SkyGuide-Azhar/SkyGuide/README.md

# SkyGuide

This project is aiming to make and control a sky pointer device which will enable the user to point and track any object in the sky.
The device can be used as a Telescope German Equatorial Go-To Mount.

The project consists of two parts:
  - Desktop app to enable the user to send the required celestial object position to the mount.
  - Physical device that recieves the required celestial object position from the desktop app and moves twoards this position.

-----------------------------------------------------------------------------------------------------------------------------------------

Participants:
  - Sherif Gamal Abdellatif
  - Abdelrahman Farouk Sayed
  - Attia Ali Attia
  - Ahmed Sedek Ali
  - Ahmed Ragab Abdelkader
