SkyGuide-Azhar/SkyGuide/Doc and Presentation/ProgramsUsed.docx

Programs Used

Python 3.9, QtCreator, Arduino IDE, TinkerCad
