SkyGuide-Azhar/SkyGuide/Hardware Device/3d Design/gyro_mount.stl

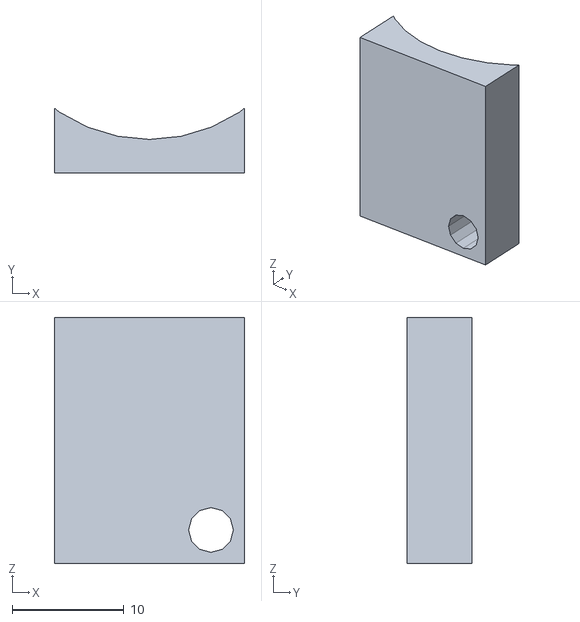
[picture p1: CAD file, 2021-09-16]
Hardware Device/3d Design/gyro_mount.stl
17.0 x 5.81 x 22.0
