SkyGuide-Azhar/SkyGuide/Hardware Device/3d Design/small_gear_DEC.stl

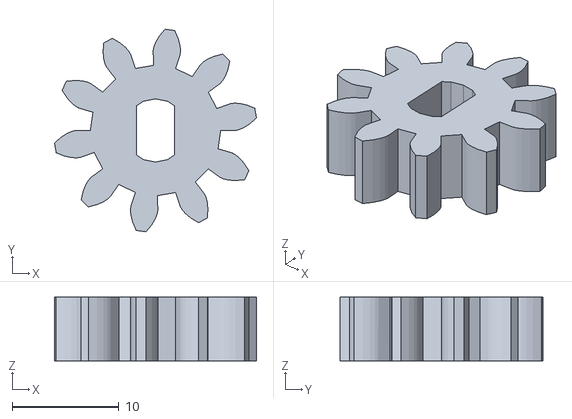
[picture p3: CAD file, 2021-09-16]
Hardware Device/3d Design/small_gear_DEC.stl
19.0 x 19.0 x 6.00
