SkyGuide-Azhar/SkyGuide/Hardware Device/3d Design/DEC_mount.stl

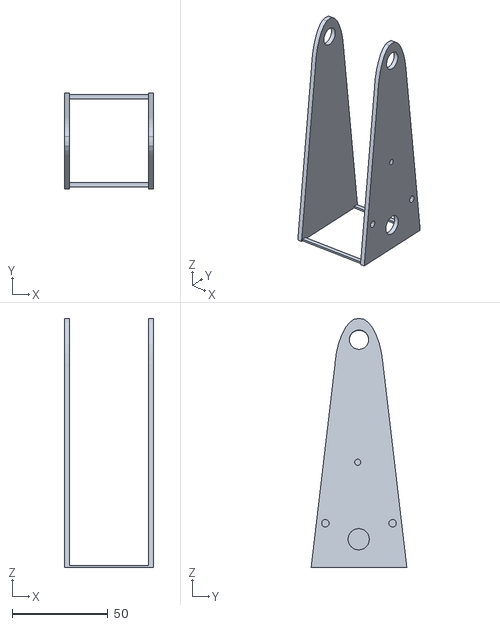
[picture p4: CAD file, 2021-09-16]
Hardware Device/3d Design/DEC_mount.stl
46.4 x 50.0 x 130.0
