SkyGuide-Azhar/SkyGuide/Hardware Device/3d Design/base_gear_small.stl

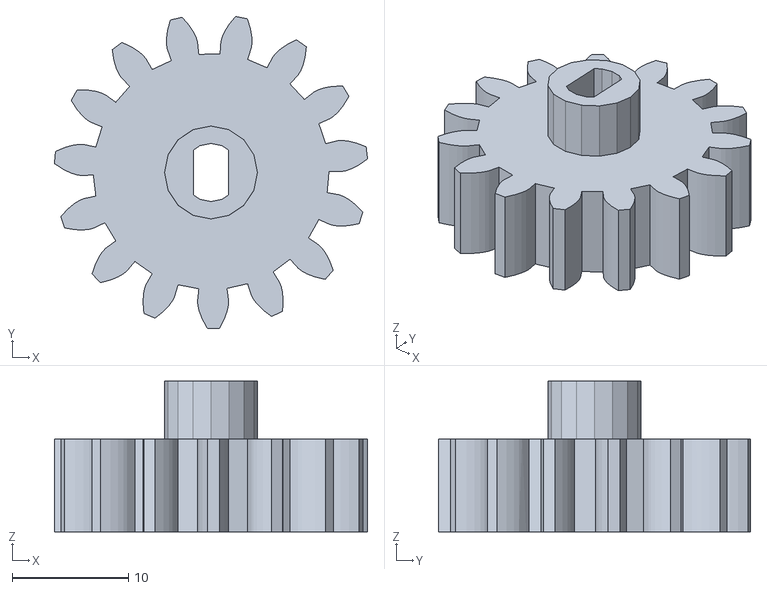
[picture p5: CAD file, 2021-09-16]
Hardware Device/3d Design/base_gear_small.stl
27.0 x 26.9 x 13.0
