SkyGuide-Azhar/SkyGuide/Hardware Device/3d Design/second_gear_DEC.stl

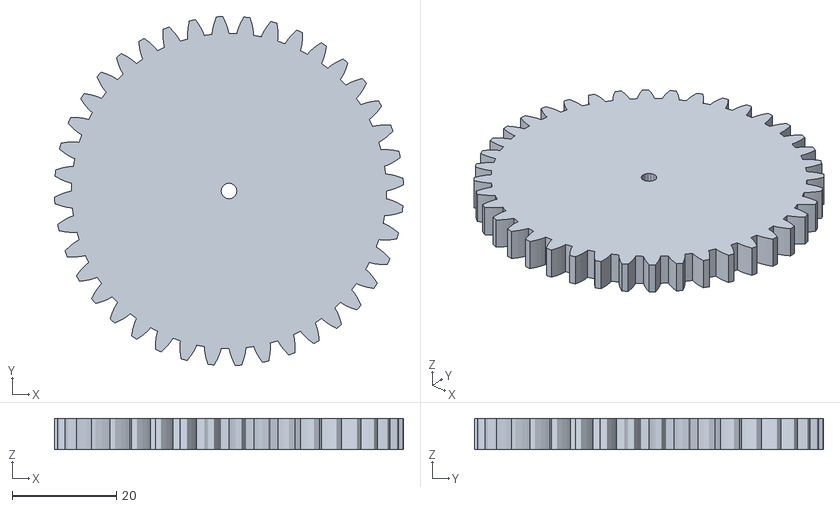
[picture p6: CAD file, 2021-09-16]
Hardware Device/3d Design/second_gear_DEC.stl
66.8 x 66.8 x 6.00
