SkyGuide-Azhar/SkyGuide/Hardware Device/3d Design/tripod_mount.stl

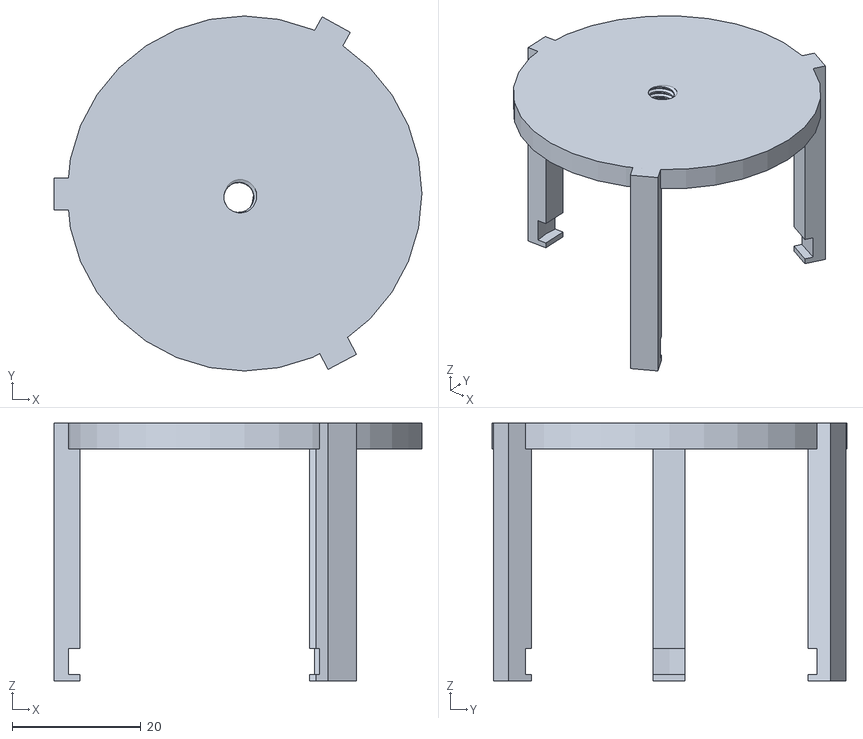
[picture p7: CAD file, 2021-09-16]
Hardware Device/3d Design/tripod_mount.stl
57.1 x 55.1 x 40.0
