SkyGuide-Azhar/SkyGuide/Hardware Device/3d Design/laser_mount.stl

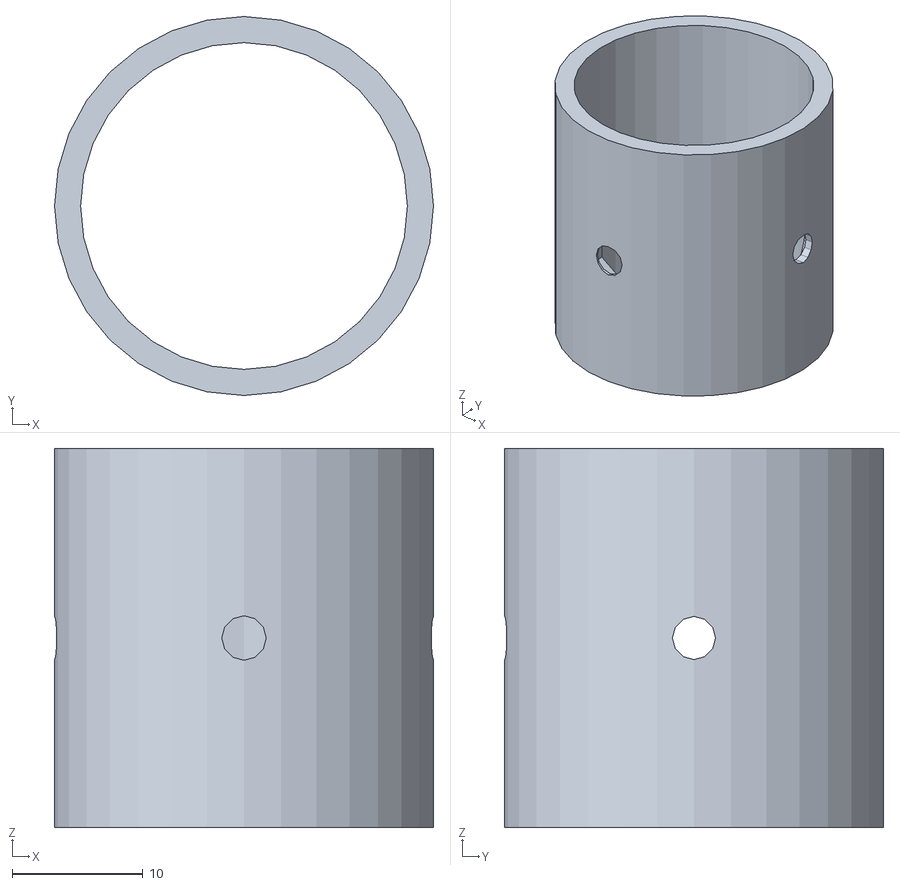
[picture p8: CAD file, 2021-09-16]
Hardware Device/3d Design/laser_mount.stl
29.0 x 29.0 x 29.0
