SkyGuide-Azhar/SkyGuide/Hardware Device/3d Design/base.stl

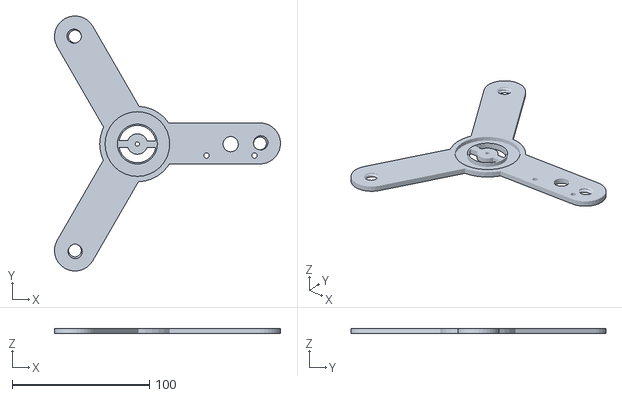
[picture p9: CAD file, 2021-09-16]
Hardware Device/3d Design/base.stl
165.0 x 186.1 x 4.00
