SkyGuide-Azhar/SkyGuide/Hardware Device/3d Design/base_gear_big.stl

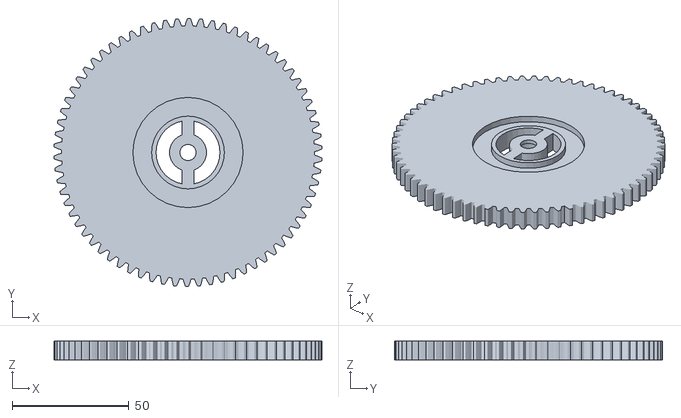
[picture p10: CAD file, 2021-09-16]
Hardware Device/3d Design/base_gear_big.stl
114.6 x 114.6 x 8.00
