SkyGuide-Azhar/SkyGuide/Hardware Device/3d Design/base_screw x 3.stl

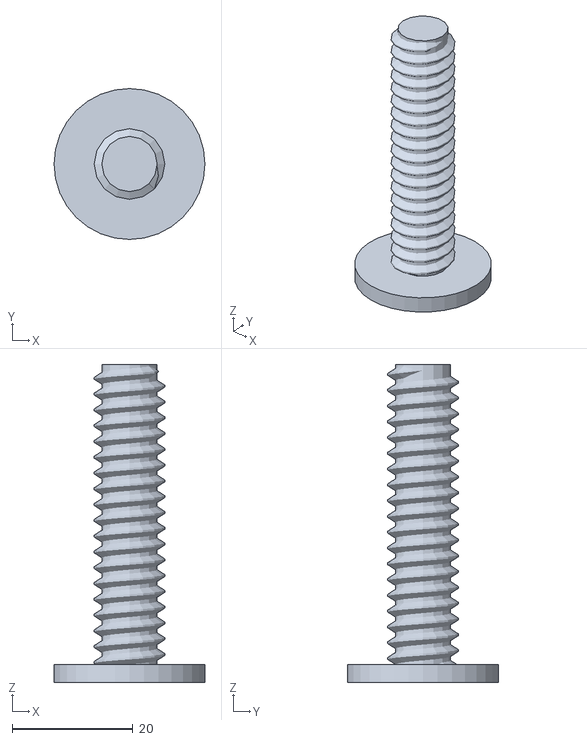
[picture p11: CAD file, 2021-09-16]
Hardware Device/3d Design/base_screw x 3.stl
25.0 x 25.0 x 52.7
