SkyGuide-Azhar/SkyGuide/Doc and Presentation/SkyGuide_Documentation.pdf

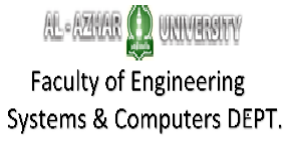
[picture p12: figure]
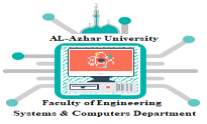
[picture p13: figure]

## Graduation Project Documentation

## Sky Guide / Tracker

## A Project Submitted in partial fulfilment of the requirements for the Degree of Bachelor of Science in Systems and Computers Engineering

## Submitted By

## Sherif Gamal Abdellatif 404045 Abdelrahman Farouk Sayed 404052

Attia Sayed Attia | 404060
Ahmed Sedek Ali | 404010
Ahmed Ragab Abdelkader | 4040111

## Supervised by Dr. Khalid Elshafey

2020/2021

Sky Guide / Tracker 2020/2021

### Each graduation project is assigned to an examiner committee. The committee has three members nominated by the graduation project committee. The examiner committee has a president, and two more members such that the project supervisor is one of the two members. The

name, rule, and signature of each examiner is shown in the following table.

### The examiners' signatures are required before students can submit their project final report/documentation. Therefore, students are responsible for

asking each examiner to sign next to his name in the following table.

Examiner Committee

Name | Rule | Signature
Prof. | President
Dr. | Supervisor
Dr. | Member

ABSTRACT

For most people, the night sky is a mystery because it’s really difficult to find a

certain object in the night sky using the naked eye, however, in reality the night sky is a

detailed map;

Just like the coordinates of any place on earth, each celestial object can be located using

specific coordinates, our project aims to exploit this fact.

Sky Guide consists of two main parts that enable the user to find and track any object in

the sky, these are:

- Desktop application:

We’ve established a moderate database, that contains a set of coordinates and

information for some of the most famous celestial objects (stars, nebulas, etc);

From the desktop application we access this database to retrieve the coordinates

of the required object, and send it to the physical device.

- Physical device:

The device receives the coordinates of the required object -from the desktop

application- and points toward it.

This project is targeting the amateur astronomers and the astrophotography community,

and it can be used as a Telescope German Equatorial Go-To Mount.

KEYWORDS: Astronomy; Astrophotography; Telescope Mount;

ACKNOWLEDGEMENTS

"Praise be to Allah, who guided us to this and we would never have been guided if

Allah had not guided us."

We would like to thank Dr. Khaled Al-Shafei for advice, encourage, support and

mentoring has offered us during project also in the class.

We would like to thank our friend and colleague Eng. Mostafa Arafa from the department

of mechanics, for helping us greatly in the design of the physical device.

Also, we would like to thank staff doctors and Engineers of facility members of the

department of systems and computer engineer for their help and encouragement.

Finally, we would like to thank our parents for support and encouragement.

TABLE OF CONTENTS

LIST OF FIGURES

### Fig 1.1: Visualization of celestial sphere around the earth

### Fig 1.2: Finding star given its RA and Dec

### Fig 1.3: Observer meridian

### Fig 2.1: Equatorial mount design

### Fig 3.1: Sky Guide database ERD

### Fig 3.2: Sky Guide backend UML diagram

### Fig 3.3: SkyGuideApp class UML diagram

### Fig 3.4: Sky Guide mount design

### Fig 3.5: Components’ Connection

### Fig 4.1: Stars table from Sky Guide database

### Fig 4.2: Example of search page in Sky Guide app

### Fig 4.3: Example of explore page in Sky Guide app

### Fig 4.4: Example of add page in Sky Guide app

### Fig 4.5: Image 1 of Sky Guide device

### Fig 4.6: Image 2 of Sky Guide device

### Fig 3.5: Components’ Connection

GLOSSARY AND LIST OF ABBREVIATION

### RA: Right Ascension

### Dec: Declination

### LST: Local Sidereal Time

### AZ: Altitude Azimuth

CHAPTER 1 INTRODUCTION

### 1.1 Background and Motivation

The sky has always been our passion and having the opportunity to combine our interest

in the sky and our knowledge in computer science was quite a motivating experience. We

have found that in the amateur astronomy and astrophotography communities, they face

quite a challenge in locating and tracking the celestial objects that they wish to observe

or study. Thus, the aim of the work described in this report is to provide a software tool

and a device controlled by this software, to find and track any celestial object across the

sky.

### 1.2 Scientific Idea

Similar to the navigation on earth, where to find a position on earth, a one must know its

coordinates -longitude and latitude, there must be a celestial coordinate system to enable

us to navigate the sky, this introduces us to the concept of “Celestial sphere” & “Celestial

coordinate systems”.

1.2.1 Celestial sphere

Celestial Sphere is an abstract sphere that has an infinite radius and shares the same

center with the Earth. We imagine that the stars and planets are attached to the inside

surface of the celestial sphere.

Standing outside on a clear moonless night far from city lights, it is easy to imagine that

one is at the center of such a sphere and that the stars and planets are attached to its

inside surface.

Extending the Earth's axis of rotation in both directions onto the celestial sphere

determines two points, the north celestial pole and the south celestial pole, similarly,

projecting the Earth's equator onto the celestial sphere determines the celestial equator.

As the Earth revolves around the Sun each year, we see the Sun seeming to

travel across the celestial sphere. As it does, it traces out an imaginary great circle,

which is called the ecliptic [1].

The plane determined by the Earth's equator is tilted with respect to the plane

determined by the ecliptic, so the Sun is north of the equator for 6 months of each year

and south of the equator for the other 6 months. The ecliptic and the equator cross at

two points, the vernal equinox and the autumnal equinox. The vernal equinox is the

point where the Sun crosses the equator on its way north each year, marking the first

day of spring in the Northern Hemisphere. See illustration fig 1.1.

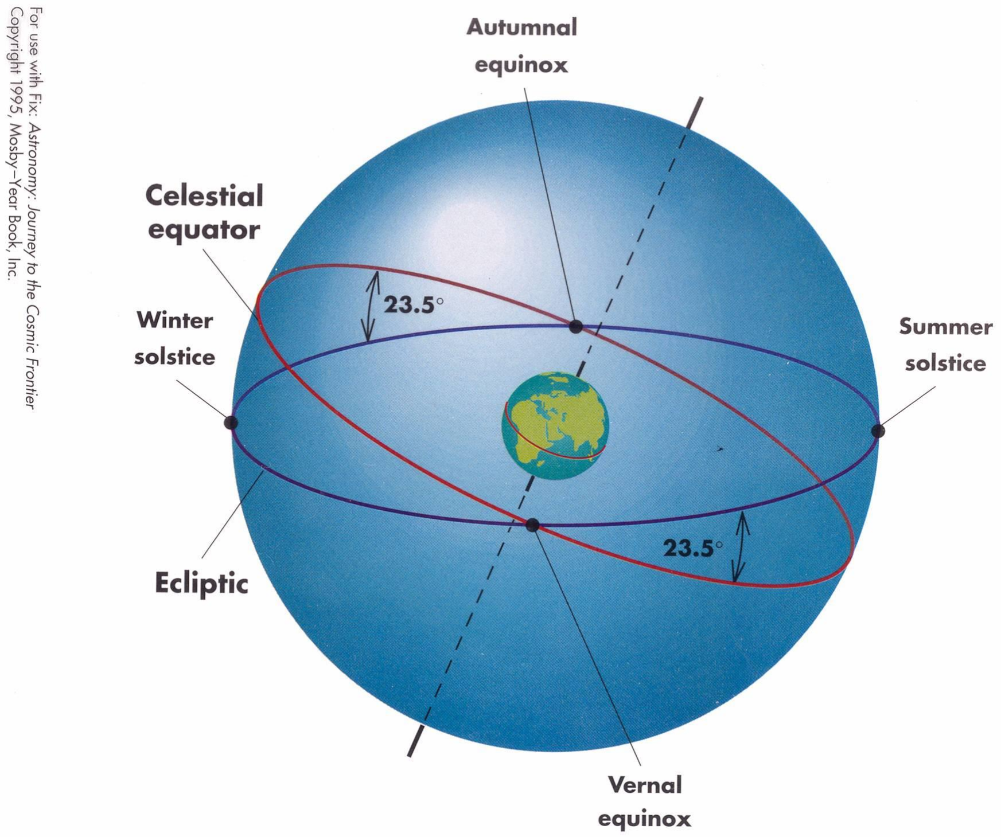
[picture p14: figure]

Fig 1.1: Visualization of celestial sphere around the earth

1.2.2 Celestial coordinate systems

There are many celestial coordinate systems, for example:

Horizontal system, Galactic system, Ecliptic system and Equatorial system -which is

used in this project.

Equatorial coordinate system:

As the distances to the stars and planets are so great, two different observers see the

same star in the same direction and thus the star can be thought of as being at a specific

“position” on the celestial sphere.

Using the two poles, the equator, and the ecliptic, it is straightforward to

establish a coordinate system that makes it possible to determine the position of any

object in the sky. The system is similar to the system of latitudes and longitudes used

for the locations of objects on the surface of the Earth. Right ascension -abbreviated RA

or with the Greek letter α- is analogous to longitude. Declination -abbreviated Dec or

with the Greek letter δ- is analogous to latitude.

As with longitude on the Earth, it is necessary to choose a “zero” point for right

ascension, we use on earth a meridian -a great semicircle from one pole to the other,

perpendicular to the equator- passing through Greenwich, England. On the celestial

sphere we use the meridian that passes through the vernal equinox. Every point on this

prime meridian has a right ascension of zero.

Right ascension is measured in hours and minutes, ranging from 0 hours, 0

minutes to 23 hours, 59.999… minutes. Hours are used rather than degrees because the

entire sphere seems to rotate once per day. Each hour of right ascension corresponds to

15°. Right ascension increases toward the east.

Declinations are measured north and south of the equator with angles between

0° and 90°, measured in degrees and minutes. Northern declinations are considered

positive, southern declinations negative.

For example: If a star is located at RA = 4.1h and Dec = 58.8°, figure 1.2 illustrates the

position of this star.

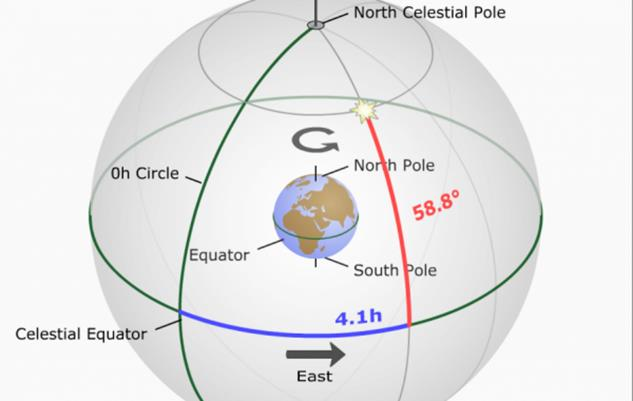
[picture p15: figure]

Fig 1.2: Finding star given its RA and Dec

1.2.3 Local sidereal time

Sidereal time is a timekeeping system that is used to locate celestial objects,

astronomers use Sidereal Time to measure the movement of the celestial sphere.

Local sidereal time (LST) is the sidereal time where

the observer’s located, it is equal to the RA of any

celestial object that is transiting the observer’s

meridian -the great circle passing through the celestial

poles, as well as the zenith and nadir of an observer's

location (see Fig 1.3)- at this particular moment, for

example the time when the vernal equinox passages

over the observer this marks the zero hour of the local

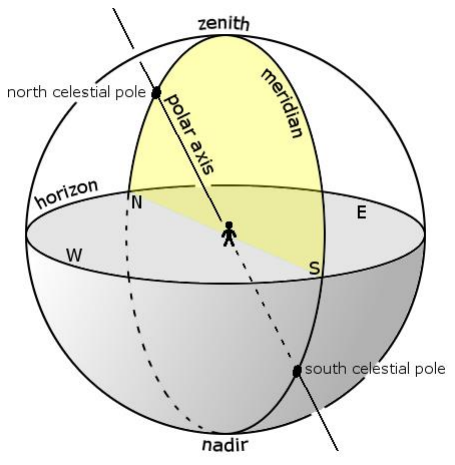
[picture p16: figure]

sidereal time. | Fig 1.3: Observer meridian

### 1.3 Problem definition

As the earth revolves around itself a full revolution per day, any celestial object seems to

be moving across the sky -from the east towards the west, due to this fact, it’s very

difficult to find the exact RA of a particular celestial object, and to track this object across

the sky. So, for a given celestial object, we shall have its coordinates -RA and Dec- and

it’s required to find this particular object and track it across the sky.

### 1.4 Survey

There are many companies develop smart mounts in order to solve these problems

Among these companies:

- Celestron:

Celestron is a company that manufactures and distributes telescopes and telescope

mount.

Examples of their telescope mounts: CGX EQUATORIAL MOUNT, Advanced VX

Go-To German EM.

- iOptron:

iOptron is a global company specializing in the development, manufacturing, and

marketing of innovative astronomical telescopes, mounts & accessories, and cutting-

edge optical instrument for multiple applications.

Examples of their telescope mounts: Urban 90, Versa AZ

- Orion:

Examples of their telescope mounts: Orion SpaceProbe II

Unfortunately, there aren’t any local companies that make similar device.

CHAPTER 2 PROPOSED APPROACH

### 2.1 Introduction

To solve the problem discussed in the previous chapter, there were many challenges that

faced us, some of these challenges are as follows:

- How to make the user select a particular celestial object?
- How to make the user input the coordinates of any celestial object?
- How to send these coordinates to the device to move towards the object?
- How to make the device receives coordinates of an object and moves towards it?
- How to make sure that the device reached its destination?
- How to make the device track the object across the sky?

To solve these challenges, we settled on the following approach.

### 2.2 Proposed approach

Our approach consists of two parts:

2.2.1 Software application

To solve the problem of enabling the user to select a particular celestial object, we have

to store the positions and some information related to the most famous celestial objects

in a database, which will be available for the user to access remotely through our

desktop application.

The desktop application will communicate with the hardware device through a

wireless communication to send the positions selected by the user. Also, it will enable

the user to perform the following actions on Sky Guide database:

- Search for a celestial object by name.
- Explore specific coordinates.
- Add a new celestial object to the database.

The following celestial objects are supported by Sky Guide database: constellations,

stars, nebulas, supernova remnants and the most famous objects in our solar system.

Finally, the desktop application will have the responsibility of updating the

coordinates of the celestial object, thus, enabling the hardware device to track it across

the sky.

2.2.2 Hardware device

We wanted to make an actual

telescope-camera mount to point the

telescope or the camera to the specified

celestial object, like the one in Fig 2.1.

Unfortunately, we are limited in the

hardware resources and materials. So,

we made a small prototype in which

instead of controlling a telescope-

camera we will control a laser which

will be pointing at the celestial object.

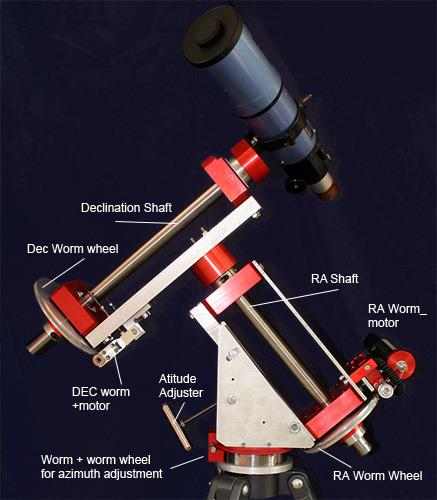
[picture p17: figure]

Fig 2.1: Equatorial mount design

The hardware device will communicate with the desktop application through a

wireless communication to receive the required angles to which the laser will be

pointing at.

CHAPTER 3 SYSTEM DESIGN AND IMPLEMENTATION

As mentioned previously, our project consists of two parts, software application and

hardware device.

### 3.1 Software part

Sky Guide desktop application consists of three main parts, database, backend and

frontend.

3.1.1 Database

The process of establishing Sky Guide database was done in three phases,

ERD, Data collection and uploading the database on clever cloud online server.

3.1.1.1 Entity relationship diagram (ERD) [2]

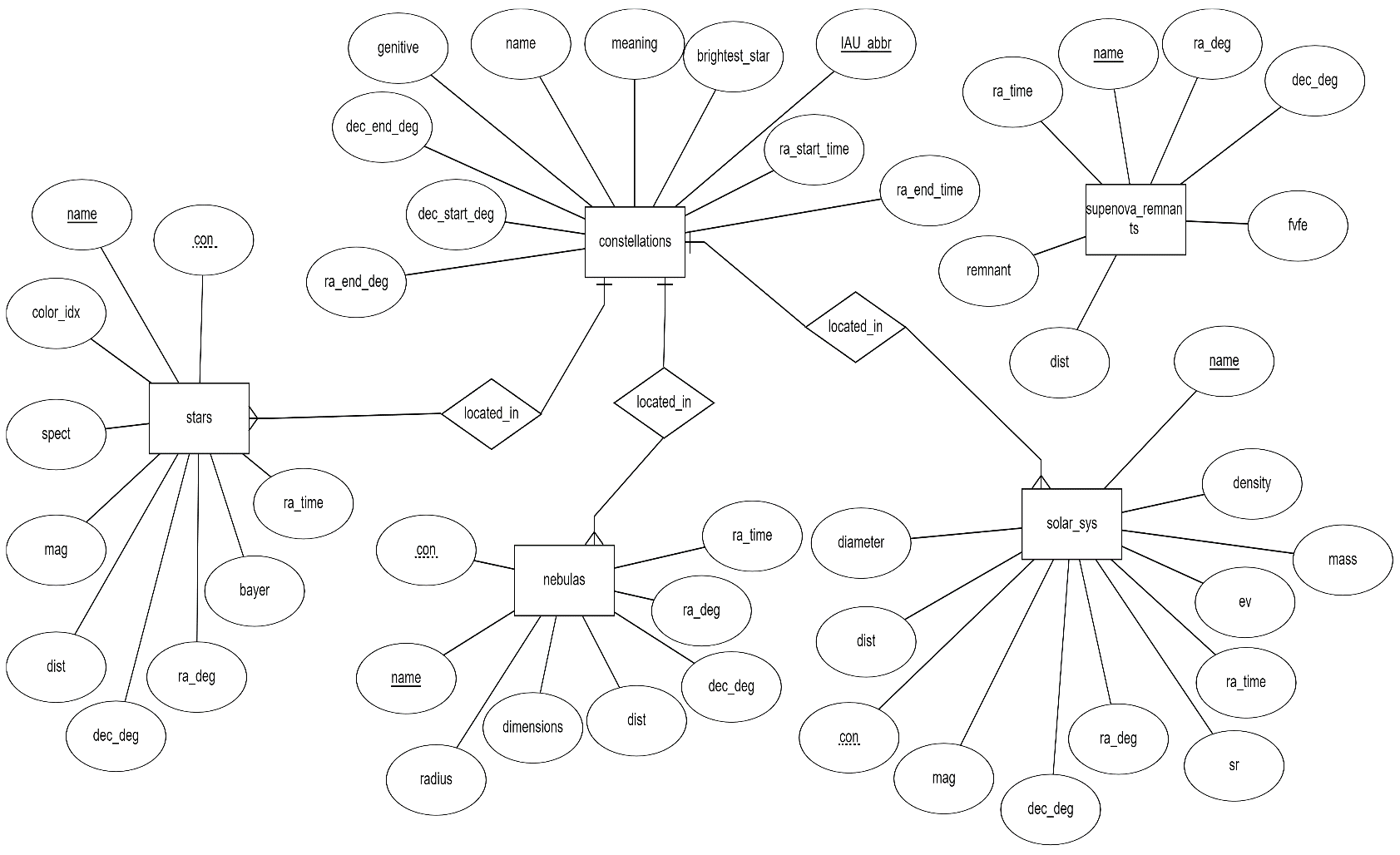
[picture p18: figure]

Fig 3.1: Sky Guide database ERD

3.1.1.2 Entities description

As shown in the previous diagram, Sky Guide database consists of five entities.

❖ Constellations: this table contains information about all the known 88

constellations, the description of these attributes are as follows [3].

- IAU_abbr: the IAU (International Astronomical Union) abbreviation, which

is a three-litter abbreviation of any constellation.

- name: the Latin name of the constellation.
- meaning: the meaning of the constellation name.
- genitive: the name of the constellation which is used in its stars’ bayer

names.

- ra_start_time: the RA position of the start point of the constellation in time

notation (h m s).

- ra_end_time: the RA position of the end point of the constellation in time

notation (h m s).

- ra_start_deg: the RA position of the start point of the constellation in

degrees.

- ra_end_deg: the RA position of the end point of the constellation in degrees.
- dec_start_deg: the Dec position of the start point of the constellation in

degrees.

- dec_end_deg: the Dec position of the end point of the constellation in

degrees.

- brightest_star: the brightest star in the constellation.

❖ Supernova remnants: this table contains information about some of the most

famous supernova remnants, the description of these attributes are as follows.

- name: the name of the supernova remnant.
- ra_time: the RA position of the supernova remnant in time notation.
- ra_deg: the RA position of the supernova remnant in degrees.
- dec_deg: the Dec position of the supernova remnant in degrees.
- dist: the approximate distance between the earth and the supernova remnant

in light years

- remnant: what it is remnant of.
- fvfe: first visible from earth.

❖ Stars: this table contains information about some of the most famous stars, the

description of these attributes are as follows [4].

- name: the name of the star.
- ra_time: the RA position of the star in time notation.
- ra_deg: the RA position of the star in degrees.
- dec_deg: the Dec position of the star.
- dist: the distance between the star and the earth.
- mag: the apparent visual magnitude of the star.
- spect: the spectral type of the star, if known.
- color_idx: the color index of the star, if known.
- bayer: the Bayer designation -a stellar designation in which the star is

identified by a Greek or Latin letter followed by the genitive form of its

parent constellation's Latin name.

- con: the IAU abbreviation of the parent constellation of the star.

❖ Nebulas: this table contains information about some of the most famous nebulas,

the description of these attributes are as follows.

- name: the name of the nebula.
- ra_time: the RA position of the nebula in time notation.
- ra_deg: the RA position of the nebula in degrees.
- dec_deg: the Dec position of the nebula.
- dist: the distance between the nebula and the earth.
- dimensions: the apparent dimensions of the nebula.
- radius: the approximate radius of the nebula in light years
- con: the IAU abbreviation of the parent constellation of the nebula.

❖ Solar system objects: this table contains information about some of solar system

objects, the description of these attributes are as follows [5].

- name: the name of the solar system object.
- ra_time: the RA position of the solar system object in time notation.
- ra_deg: the RA position of the solar system object in degrees.
- dec_deg: the Dec position of the solar system object.
- dist: the distance between the solar system object and the earth.
- mag: the apparent visual magnitude of the solar system object.

- mass: the mass of the solar system object in kilograms.
- ev: the required escape velocity of the solar system object in km/s
- sr: the solar system object sidereal rotation in hours.
- diameter: the solar system object diameter in Kilometers.
- density: the density of the solar system object in gr/cm^3.
- con: the IAU abbreviation of the parent constellation of the solar system

object.

3.1.1.3 Uploading on CleverCloud server

To make the database of Sky Guide accessible remotely, we uploaded it on an online

MySQL server supported by clever cloud [6].

Clever Cloud is a Europe-based PaaS company, that help developers deploy and

run their apps with bulletproof infrastructure, automatic scaling, fair pricing and other

features. Among those features, free MySQL hosting, of course with some limitations.

3.1.2 Backend

In this section we’ll discuss Sky Guide desktop application backend, and some of the

important points regarding the application.

3.1.2.1 Programming language used

In the development of Sky Guide application, we used Python-3.9 as the backend

programming language, we chose Python because it’s a simple and powerful language,

and recently we have studied it, and all of Sky Guide team are familiar and have some

experience with it.

3.1.2.2 Device connection

Sky Guide mount wireless communication with the application is done using a

Bluetooth connection, we used a serial communication module called PySerial [7], to

configure the app to communicate with the mount which will be connected to one of the

OS Bluetooth COM ports.

Once the application starts, it tries to connect with the mount, and sends the

appropriate angles to it, then it waits for the confirmation, if the confirmation wasn’t

sent back, the app will disconnect, and retry to initiate the connection again, this process

is done until the application is closed by the user.

3.1.2.3 LST calculations

As the application is responsible to send the correct angels to the mount of the celestial

object, it has to calculate the difference between the current LST and the object’s RA,

and then sends an updated angel of this object’s RA to the mount, this is done

continuously to ensure that the pointer finds and follows the celestial object in the sky. The calculation of the local sidereal time was taken form “Astronomical algorithms 2nd

edition” by Jean Meeus, chapter 12 [8].

3.1.2.4 Application threads

Sky Guide application consists of three threads: main thread, internet checking thread

and mount communication thread.

| In the internet checking thread, we continuously check for the internet

connection, as it is needed to connect and execute queries on Sky Guide online

database.

| In the mount communication thread, we continuously send the Dec and the

updated RA angles to the mount, thus, enabling the mount to find and track the celestial

object in the sky.

3.1.2.5 UML diagram

Sky Guide backend is a three-layered architecture: Data access layer, Business layer and

Application layer. Following is the UML of these layers.

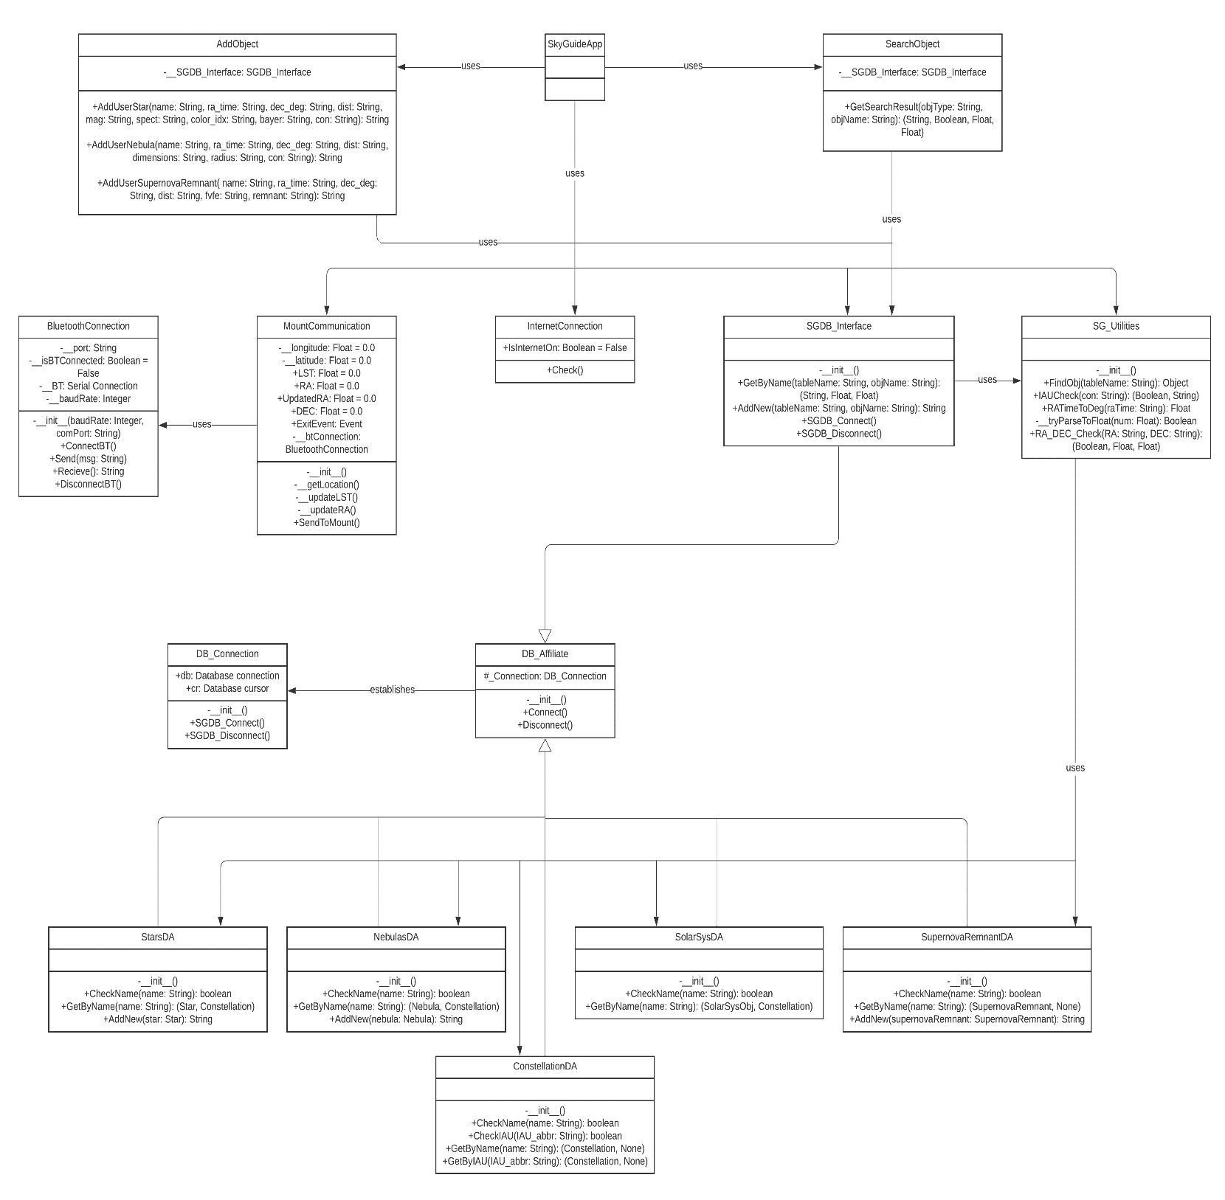
[picture p19: figure]

Fig 3.2: Sky Guide backend UML diagram

The “SkyGuideApp” class contains all the signals and the slots. Which will be used to connect

with the frontend of the app-we didn’t add it’s details to avoid complexity in the uml design,

following is the uml of the class,

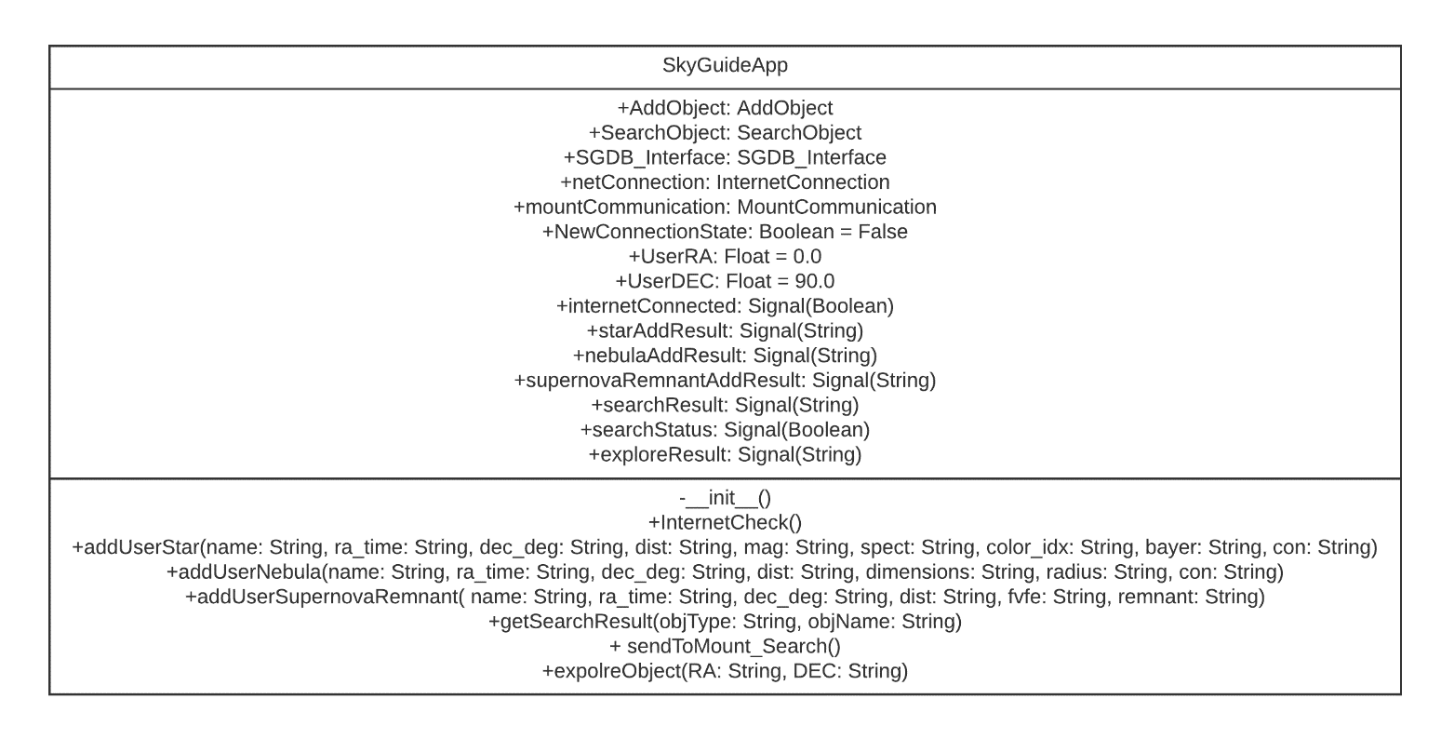
[picture p20: figure]

Fig 3.3: SkyGuideApp class UML diagram

3.1.3 Frontend

Sky Guide frontend is developed using Qt, Qt is a widget toolkit for creating graphical

user interfaces as well as cross-platform applications that run on various software and

hardware platforms.

Sky Guide application user interface will be simple and easy to use, it will

enable the user to perform the following actions on Sky Guide database:

- Search for a celestial object by name.
- Explore specific coordinates.
- Add a new celestial object to the database.

Also, will enable the user to control the celestial coordinate that the mount is pointing

at.

### 3.1 Hardware part

Following we discuss some important points regarding Sky Guide laser mount.

3.1.1 Device body

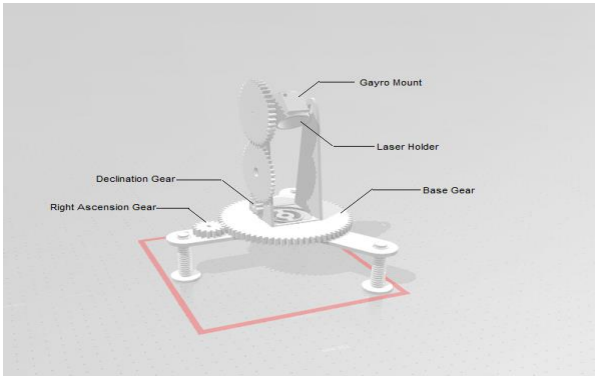
[picture p21: figure]

Fig 3.4: Sky Guide mount design

The design of the device body was created using Tinkercad, Tinkercad is a free-

of-charge, online 3D modelling program that runs in a web browser, known for its

simplicity and ease of use.

3.1.2 Used components

To execute the logic of the mount we will use the following components: Arduino uno,

stepper motor, stepper motor driver, gyroscope sensor and Bluetooth module.

- Arduino uno (x2): we shall be using two Arduino Unos, as master and slave,
- The master will be responsible for receiving the RA and Dec angles

from the desktop app, comparing them with the gyroscope sensor

readings, and sending the appropriate control signals to the slave.

- The slave will be responsible for receiving the control signals from

the master and accordingly control the 2 stepper motors.

- Stepper motor (28BYJ-48) (x2): we shall be using two stepper motors to

control both the right ascension gear and the declination gear.

- Stepper motor driver (ULN2003AN) (x2): we shall be using two drivers to

interface the slave Arduino uno with the stepper motors.

- Gyroscope sensor (MPU6050): MPU6050 is a Micro Electro-mechanical

system (MEMS), it consists of three-axis accelerometer and three-axis

gyroscope. It helps us to measure velocity, orientation, acceleration,

displacement, and other motion like features. We shall be using it as a

feedback sensor representing the current positions of the stepper motors, it

will be connected to the master Arduino uno and used to compare the angles

sent by the app and the current positions of the stepper motor

- Bluetooth module (HC-50): we have changed the module’s name to

SkyGuide, and this module will be used to communicate with Sky Guide

application.

3.1.3 Components’ connection

Following is the component connection for Sky Guide mount.

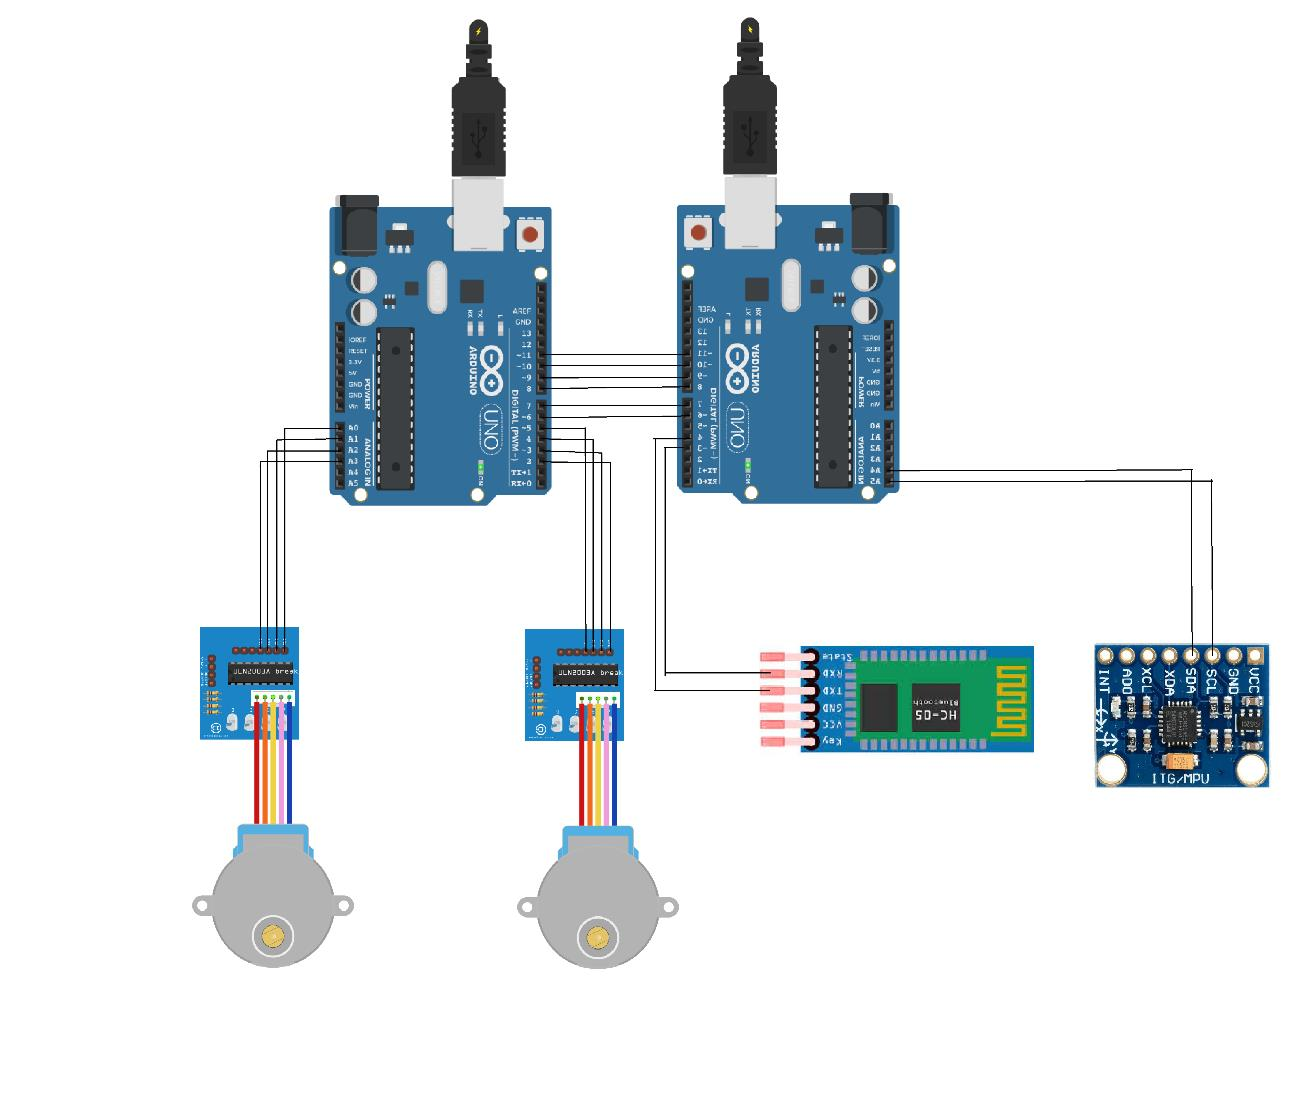
[picture p22: figure]

Fig 3.5: Components’ Connection

3.1.4 Device firmware

In Appendix A you will find the firmware of both the master and the slave Arduino uno(s).

CHAPTER 4 RESULTS AND DISCUSSION

### 4.1 Results

Following are the results of our project both software and hardware.

4.1.1 Software result

We have successfully built the desktop application as discussed in the previous chapter.

All the source code of our application can be found on SkyGuide GitHub repository [9].

4.1.1.1 Database result

The following figure is a screenshot of the “stars” table in Sky Guide database -we used

HeidiSQL application to create and display the database- all the SQL code of the database

can be found on SkyGuide GitHub repository [9].

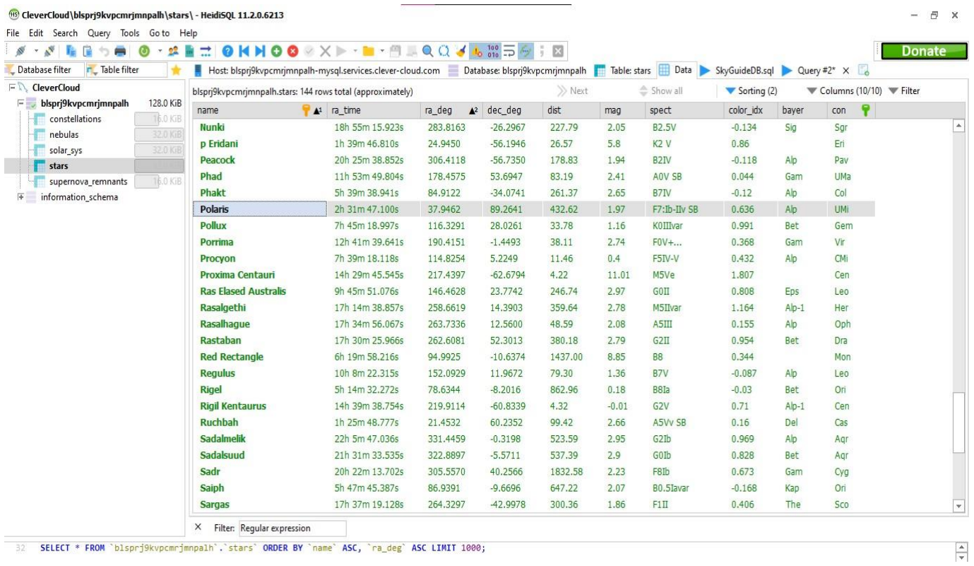
[picture p23: figure]

Fig 4.1: Stars table from Sky Guide database

4.1.1.2 User experience result

Screenshot of the SkyGuide application Search page

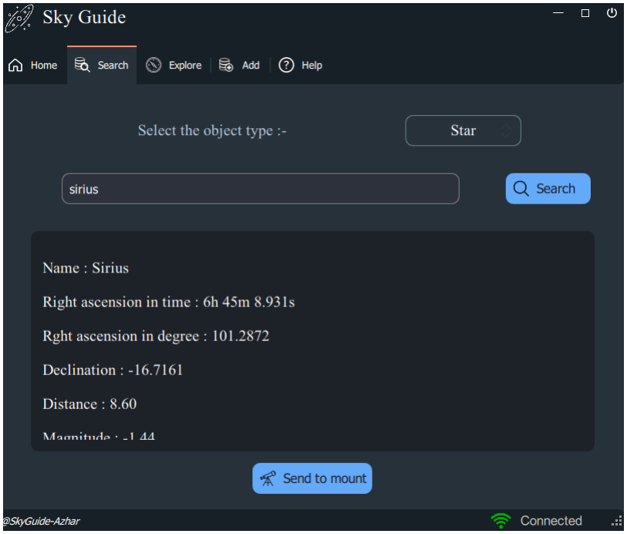
[picture p24: figure]

Fig 4.2: Example of search page in Sky Guide app

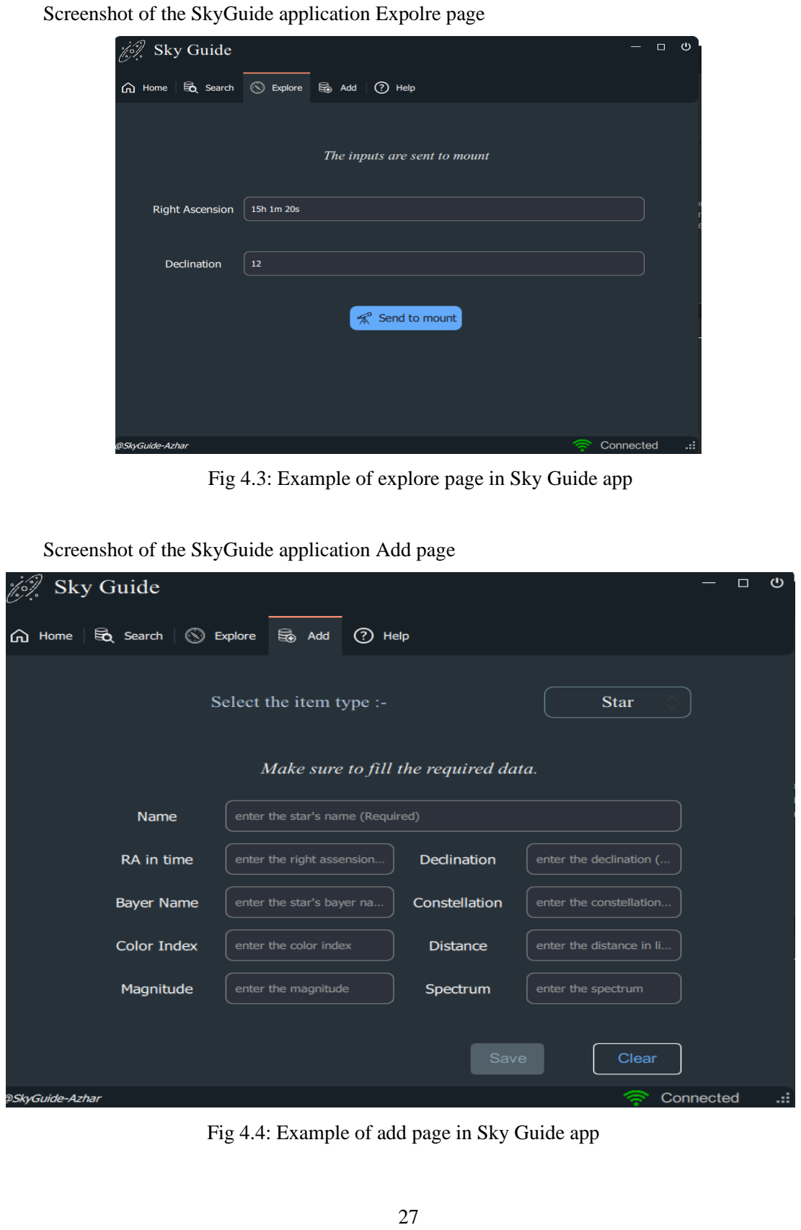
[picture p25: page 27]

Screenshot of the SkyGuide application Expolre page

Fig 4.3: Example of explore page in Sky Guide app

Screenshot of the SkyGuide application Add page

Fig 4.4: Example of add page in Sky Guide app

4.1.2 Hardware result

We have printed the design and connected the components, following are images of the

device.

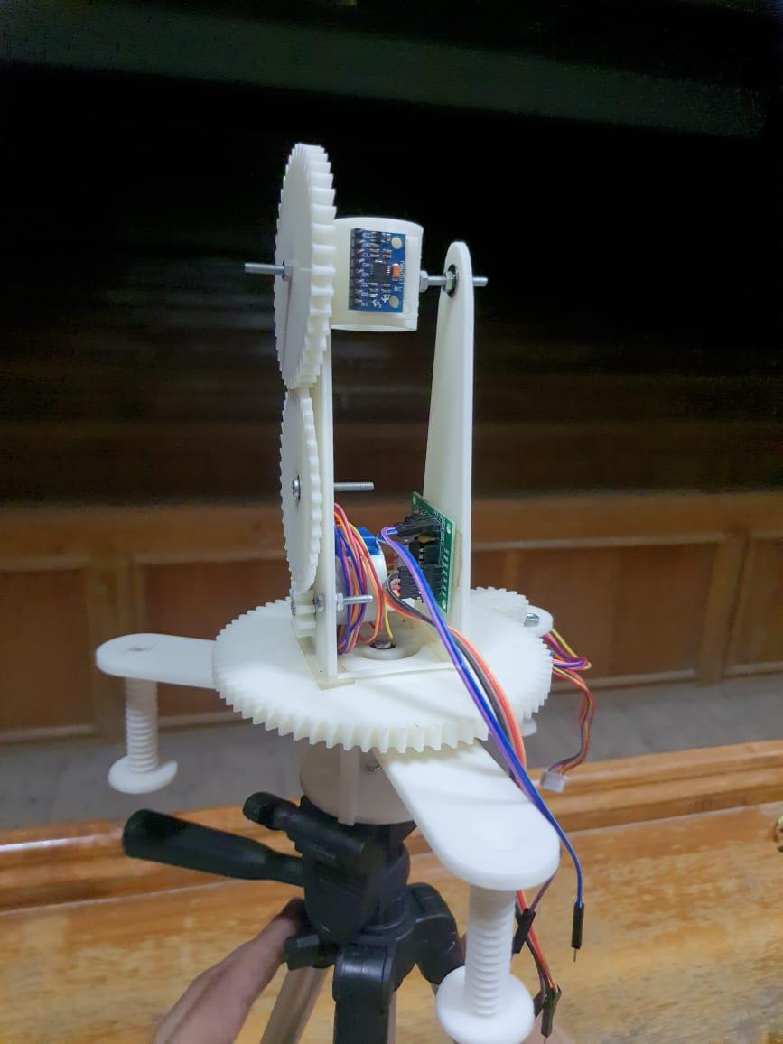
[picture p26: figure]

Fig 4.5: Image 1 of Sky Guide device

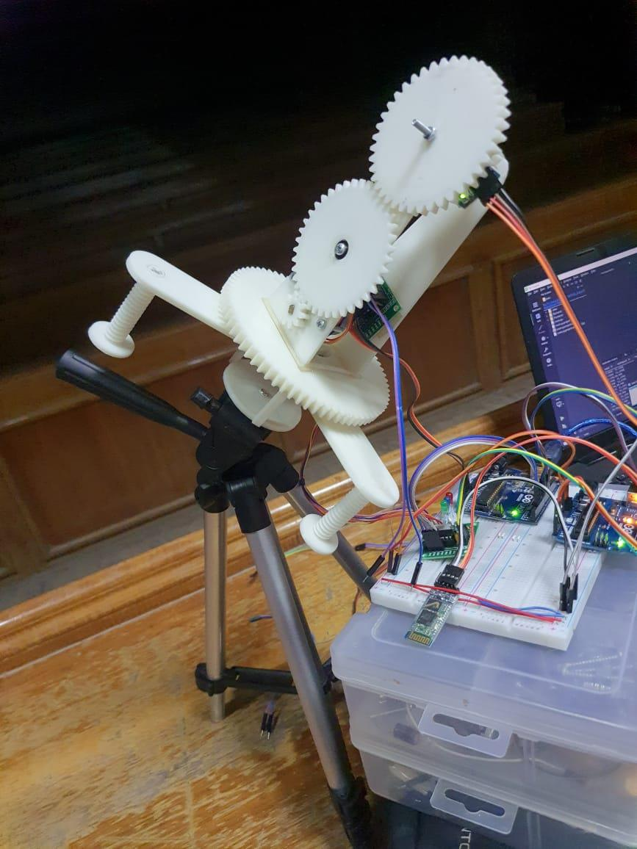
[picture p27: figure]

Fig 4.6: Image 2 of Sky Guide device

### 4.2 Discussion

We have successfully uploaded Sky Guide database on Clever Cloud online MySQL host,

and executed the application and mount connection using Bluetooth as intended,

however, the components’ connection was very challenging, and we could not improve it

to make the mount smooth as intended.

CHAPTER 5 CONCLUSION AND FUTURE WORK

### 5.1 Conclusion

Sky Guide device was able to solve the problem that we have described in the previous

chapters, we were able to:

- Enable the user to select a celestial object by its name and send its

coordinates to the mount to point at that object.

- Enable the user to add a new celestial object to Sky Guide database in a

robust fashion and access it remotely later.

- Enable the user to explore a particular coordinate on the celestial sphere.
- Enable the user to track the celestial object across the sky.

### 5.2 Future work

Following is our recommendation for the future work on Sky Guide project.

❖ Regarding software

1. Enable the user to view the content of a table in Sky Guide database to

choose from.

2. Enable the user to update the solar system table data from the app on

command.

3. Substitute the Bluetooth connection with a more robust wireless

connection.

4. Enable the user to view the current positions of the mount from Sky Guide

application.

❖ Regarding hardware

1. Build a mount that will be able to carry a telescope or a camera and make

them point at the sky.

2. Build a firmware based on a microcontroller other than Arduino.
3. Solve the issues of wires connection.
4. Add the tracking feature to the hardware, to make it less error-prone.

## REFRENCES

[1] D. Ford, The Observer's Guide to Planetary Motion, New York: Springer, 2014.
[2] ERDPlus, “ERDPlus,” [Online]. Available: https://erdplus.com/.
[3] Wikipedia, “IAU_designated_constellations,” [Online]. Available:

https://en.wikipedia.org/wiki/IAU_designated_constellations.

[4] D. Nash, “HYG-Database,” 2011. [Online]. Available:

https://github.com/astronexus/HYG-Database.

[5] TheSkyLive, “TheSkyLive,” [Online]. Available: https://theskylive.com/.
[6] CloudClever, “Clever Cloud,” [Online]. Available: https://www.clever-

cloud.com/en/.

[7] PyPi, “PySerial,” [Online]. Available: https://pypi.org/project/pyserial/.
[8] J. Meeus, Astronomical Algorithms, 2 ed., Virginia: Wilmann-Bell, Inc, 1998, pp.

95-98.

[9] SkyGuide-Azhar, “SkyGuide,” 2021. [Online]. Available:

https://github.com/SkyGuide-Azhar/SkyGuide.

APPENDICES

Appendix A: Arduino Master Code:

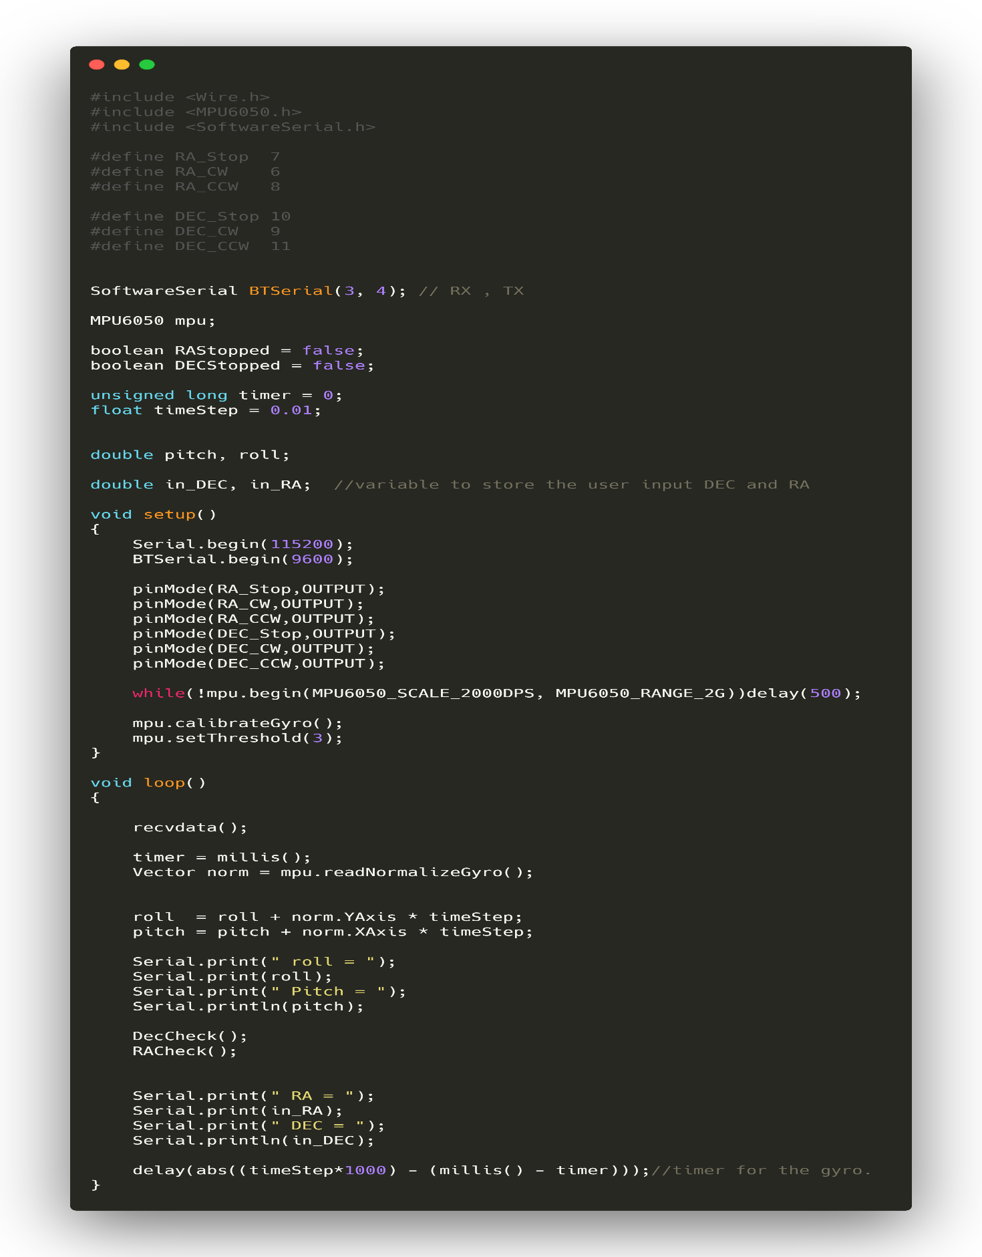
[picture p28: figure]
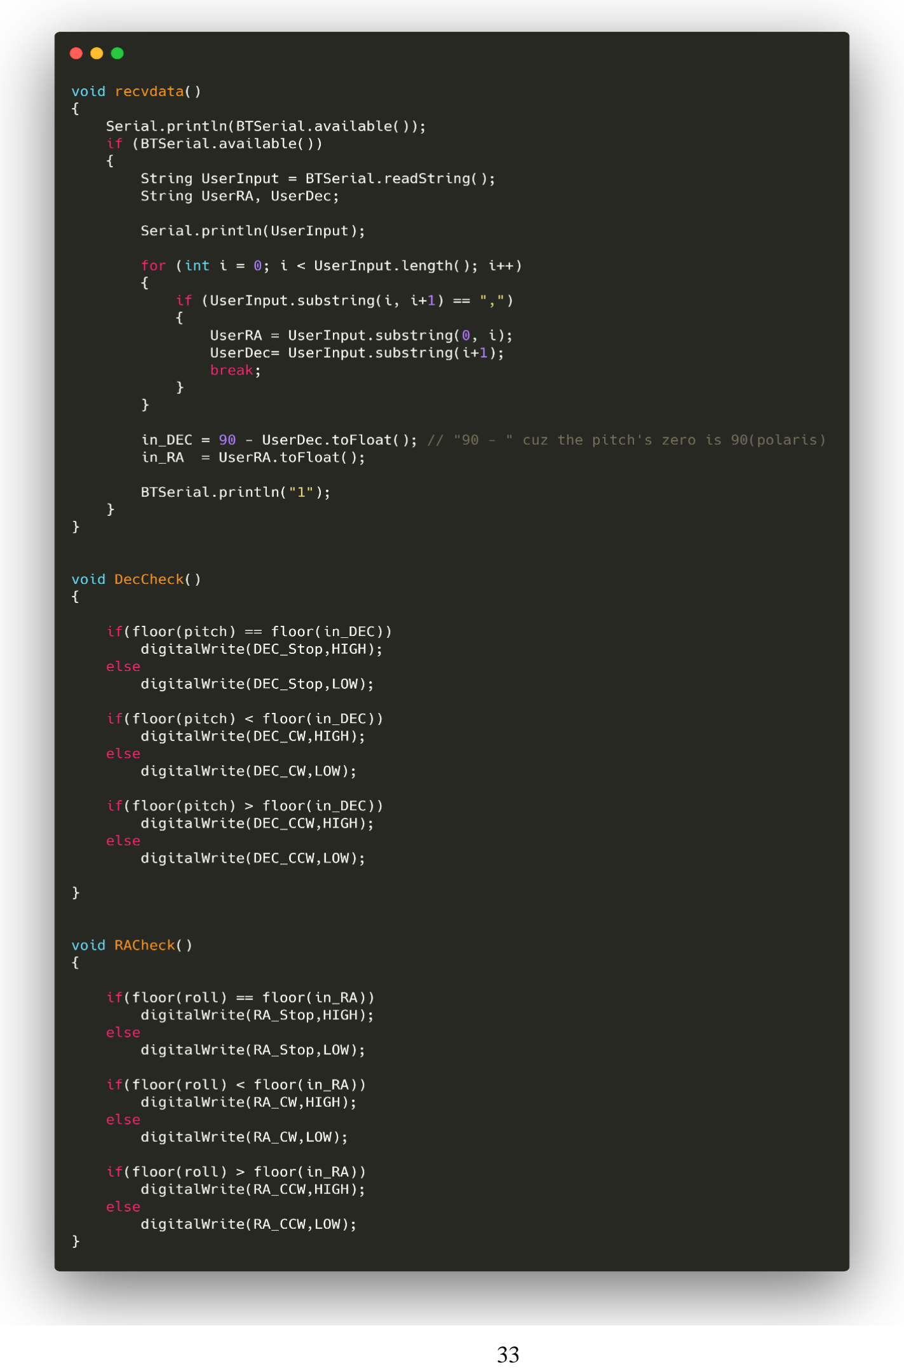
[picture p29: page 33]

Slave Code:

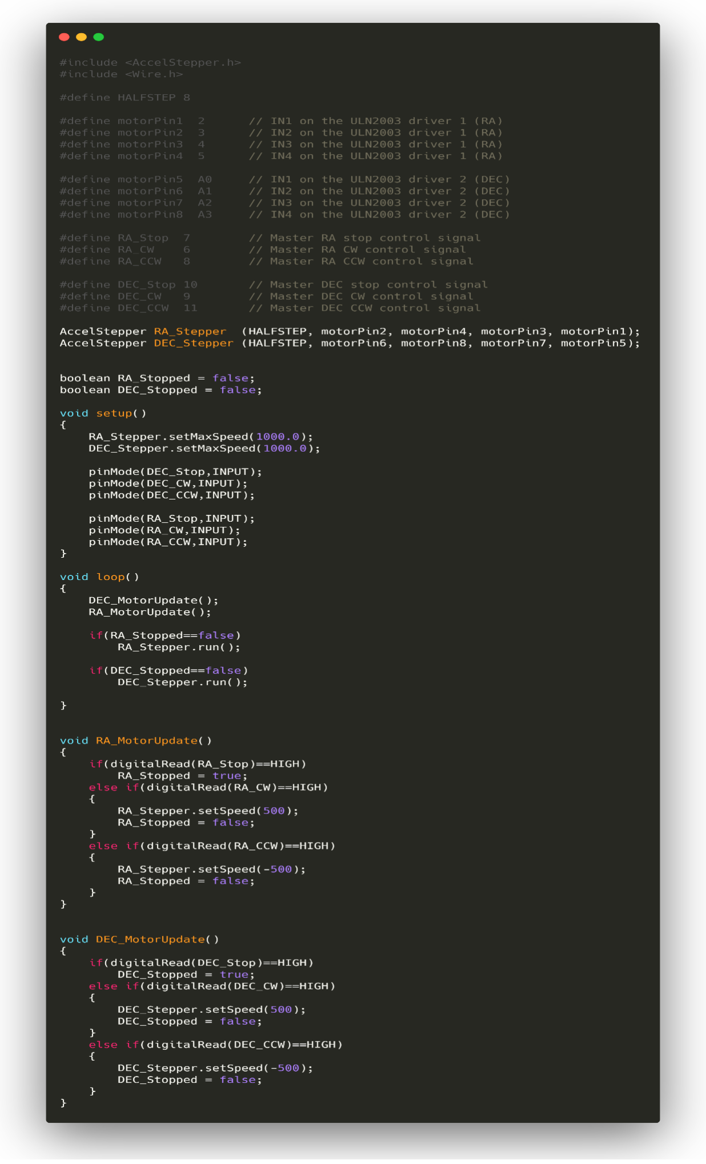
[picture p30: figure]
