SkyGuide-Azhar/SkyGuide/Desktop Application/SkyGuide/Frontend/images/png_images/galaxy.png

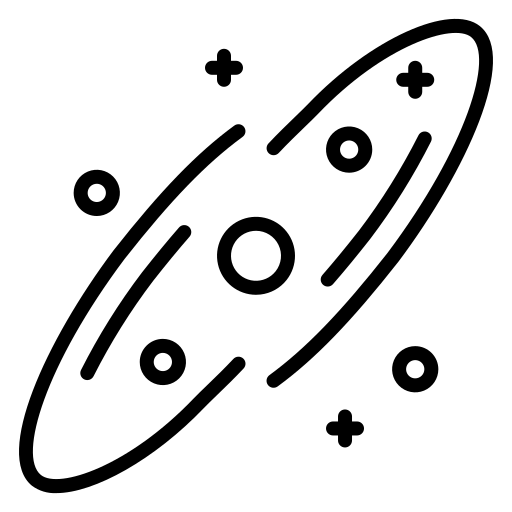
Desktop Application/SkyGuide/Frontend/images/png_images/galaxy.png
