SkyGuide-Azhar/SkyGuide/Desktop Application/SkyGuide/Frontend/images/png_images/shit.PNG

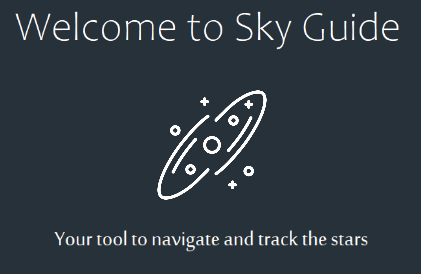
Desktop Application/SkyGuide/Frontend/images/png_images/shit.PNG
