SkyGuide-Azhar/SkyGuide/(commit log)

2021-07-04 Adding NetCheck and MountCommunication
2021-07-05 Updated MountCommunication
2021-07-24 Printing Modifications
2021-09-16 Organize Project Folder
    [DEC_mount.stl, base.stl, base_gear_big.stl, base_gear_small.stl, base_screw x 3.stl, first_gear_DEC.stl, gyro_mount.stl, laser_mount.stl]
